74th/stack-chan/schematics/m5-pantilt/m5-pantilt.kicad_pcb

## KiCad design schematics/m5-pantilt/m5-pantilt.kicad_pcb (2024-06-17)

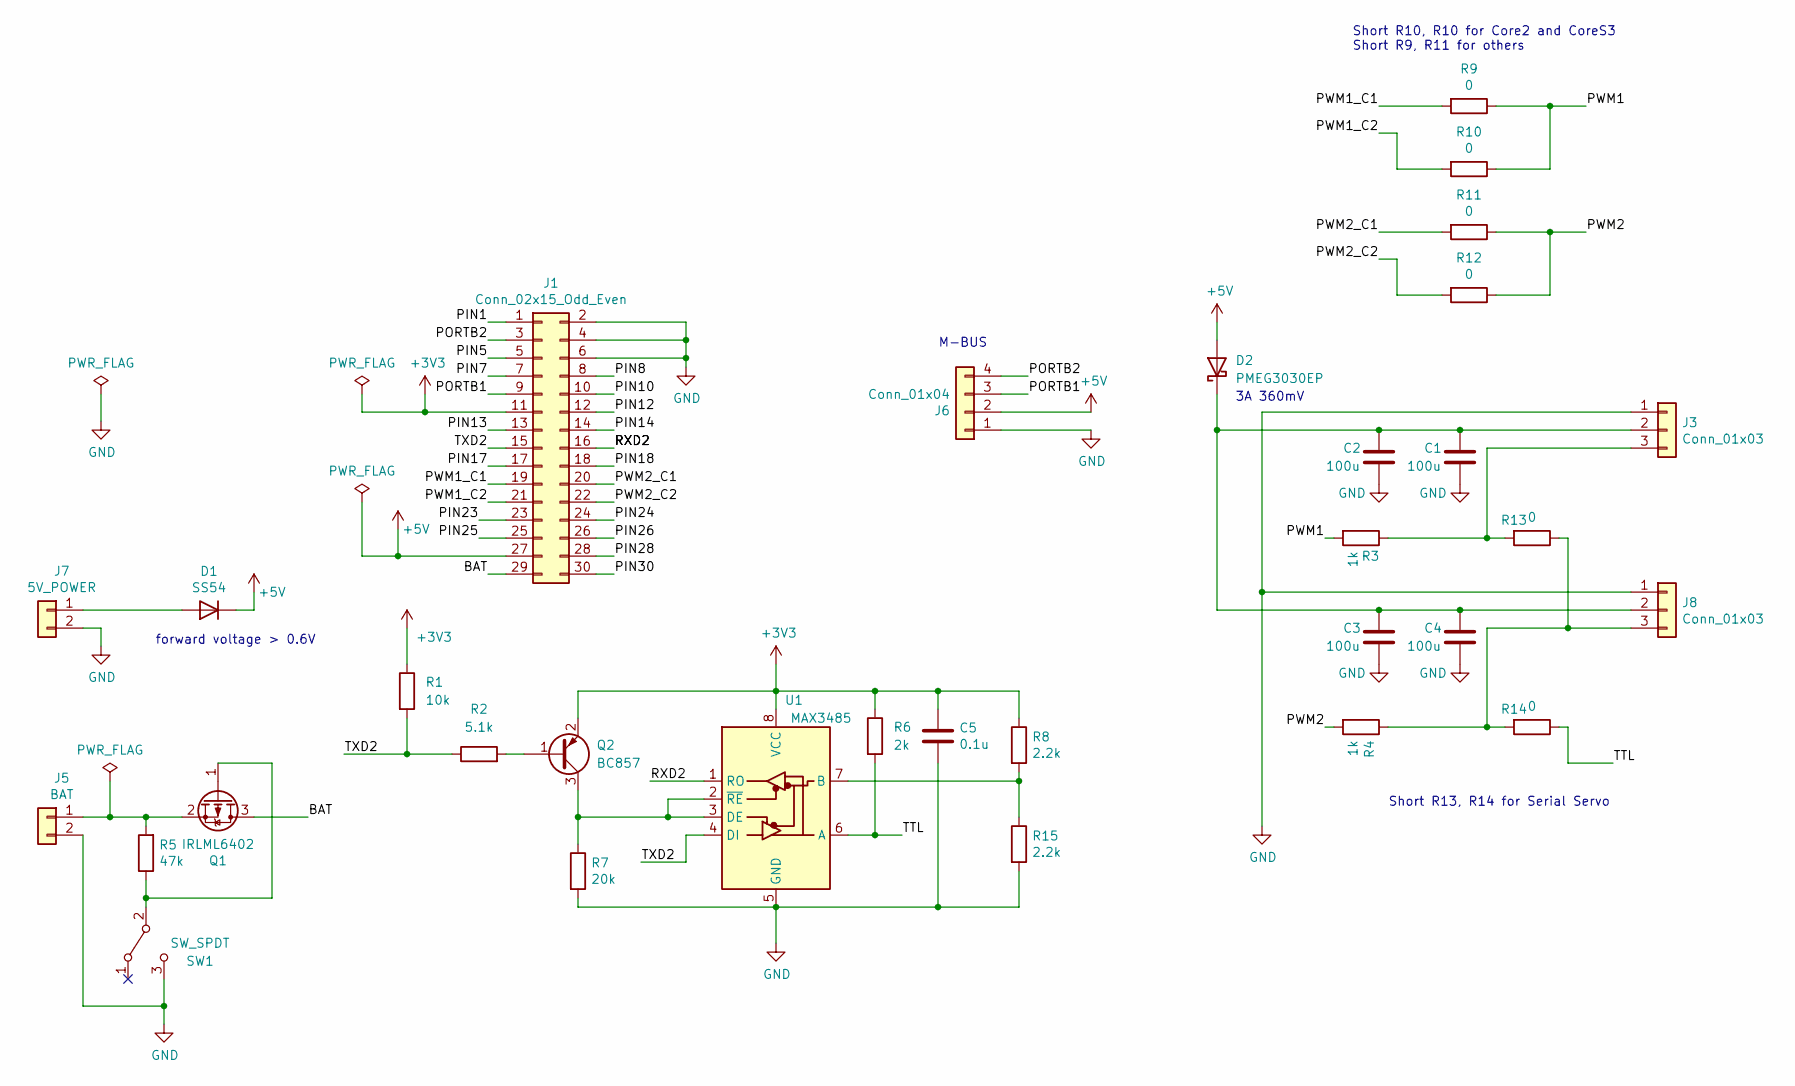
[picture p1: schematic m5-pantilt.kicad_sch]

Parts:
C1, C2, C3, C4: 100u; C_1206_3216Metric_Pad1.33x1.80mm_HandSolder; LCSC C15008
C5: 0.1u; C_0603_1608Metric; LCSC C14663
D1: SS54; D_SMA; LCSC C2931790
D2: PMEG3030EP; D_SOD-128; LCSC C255587
J1: Conn_02x15_Odd_Even; PinHeader_2x15_P2.54mm_Vertical_SMD
J3, J8: Conn_01x03; JST_EH_B3B-EH-A_1x03_P2.50mm_Vertical
J5: BAT; JST_PH_B2B-PH-K_1x02_P2.00mm_Vertical; LCSC C2319
J6: Conn_01x04; JST_PH_S4B-PH-K_1x04_P2.00mm_Horizontal
J7: 5V_POWER; JST_XH_B2B-XH-A_1x02_P2.50mm_Vertical; LCSC C20079
Q1: IRLML6402; SOT-23; LCSC C2886430
Q2: BC857; SOT-23; LCSC C2139
R1: 10k; R_0603_1608Metric; LCSC C25804
R2: 5.1k; R_0603_1608Metric; LCSC C23186
R3, R4: 1k; R_0603_1608Metric_Pad0.98x0.95mm_HandSolder; LCSC C21190
R5: 47k; R_0603_1608Metric_Pad0.98x0.95mm_HandSolder; LCSC C25819
R6: 2k; R_0603_1608Metric; LCSC C22975
R7: 20k; R_0603_1608Metric; LCSC C4184
R8, R15: 2.2k; R_0603_1608Metric; LCSC C4190
R9, R10, R11, R12: 0; R_0603_1608Metric_Pad0.98x0.95mm_HandSolder; LCSC C21189
R13, R14: 0; R_0603_1608Metric; LCSC C21189
SW1: SW_SPDT; SW_CuK_OS102011MA1QN1_SPDT_Angled
U1: MAX3485; SO-8_5.3x6.2mm_P1.27mm; LCSC C668204

Connections:
+3V3: C5.1, J1.11, Q2.2 (E), R1.1, R6.1, R8.1, U1.8 (VCC)
+5V: D1.1 (K), D2.2 (A), J1.27, J6.2
/BAT: J1.29, Q1.3 (D)
/PIN1: J1.1
/PIN5: J1.5
/PIN7: J1.7
/PIN8: J1.8
/PIN10: J1.10
/PIN12: J1.12
/PIN13: J1.13
/PIN14: J1.14
/PIN17: J1.17
/PIN18: J1.18
/PIN23: J1.23
/PIN24: J1.24
/PIN25: J1.25
/PIN26: J1.26
/PIN28: J1.28
/PIN30: J1.30
/PORTB1: J1.9, J6.3
/PORTB2: J1.3, J6.4
/PWM1: R3.2, R9.1, R10.1
/PWM1_C1: J1.19, R9.2
/PWM1_C2: J1.21, R10.2
/PWM2: R4.2, R11.1, R12.1
/PWM2_C1: J1.20, R11.2
/PWM2_C2: J1.22, R12.2
/RXD2: J1.16, U1.1 (RO)
/TTL: R6.2, R14.1, U1.6 (A)
/TXD2: J1.15, R1.2, R2.1, U1.4 (DI)
GND: C1.1, C2.1, C3.2, C4.1, C5.2, J1.2, J1.4, J1.6, J3.1, J5.2, J6.1, J7.2, J8.1, R7.2, R15.2, SW1.3 (C), U1.5 (GND)
unnamed: D1.2 (A), J7.1
unnamed: C1.2, C2.2, C3.1, C4.2, D2.1 (K), J3.2, J8.2
unnamed: J3.3, R3.1, R13.2
unnamed: J5.1, Q1.2 (S), R5.2
unnamed: J8.3, R4.1, R13.1, R14.2
unnamed: Q1.1 (G), R5.1, SW1.2 (B)
unnamed: Q2.1 (B), R2.2
unnamed: Q2.3 (C), R7.1, U1.2 (~RE), U1.3 (DE)
unnamed: R8.2, R15.1, U1.7 (B)

Notes on the sheet:
M-BUS
Short R13, R14 for Serial Servo
forward voltage > 0.6V
3A 360mV
Short R10, R10 for Core2 and CoreS3 Short R9, R11 for others

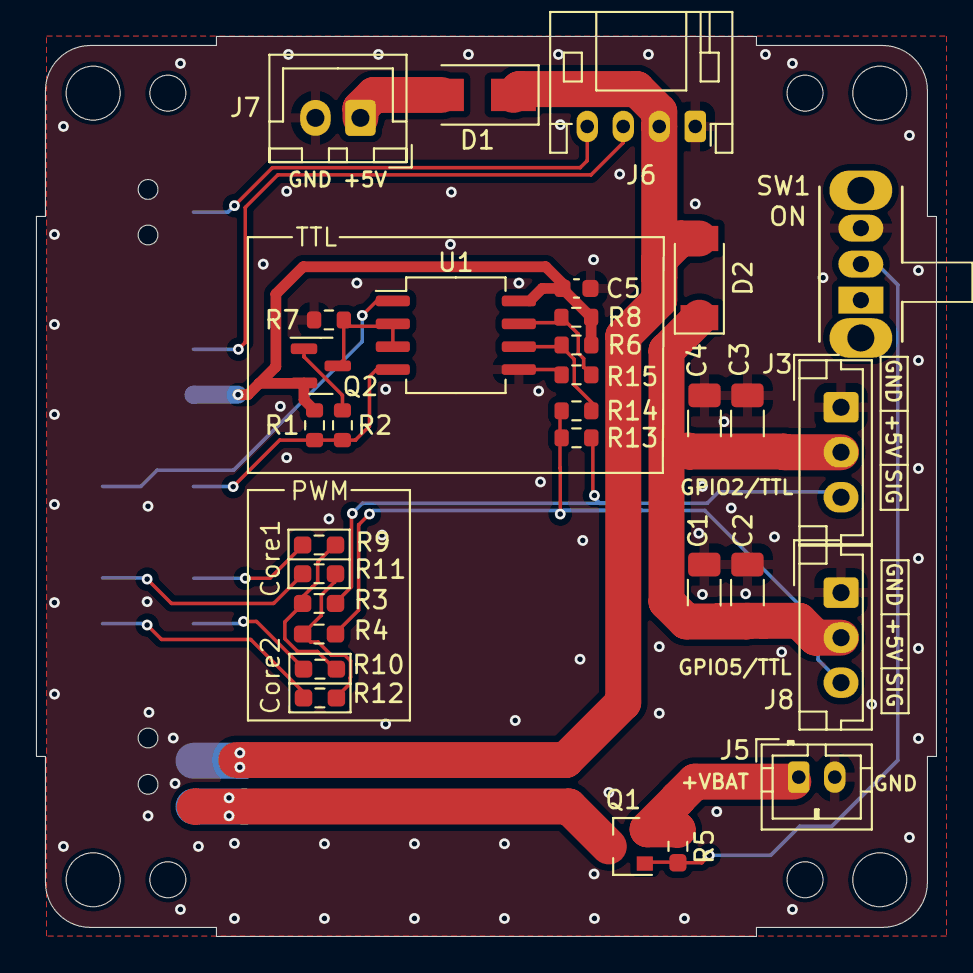
[picture p2: board m5-pantilt.kicad_pcb from above]

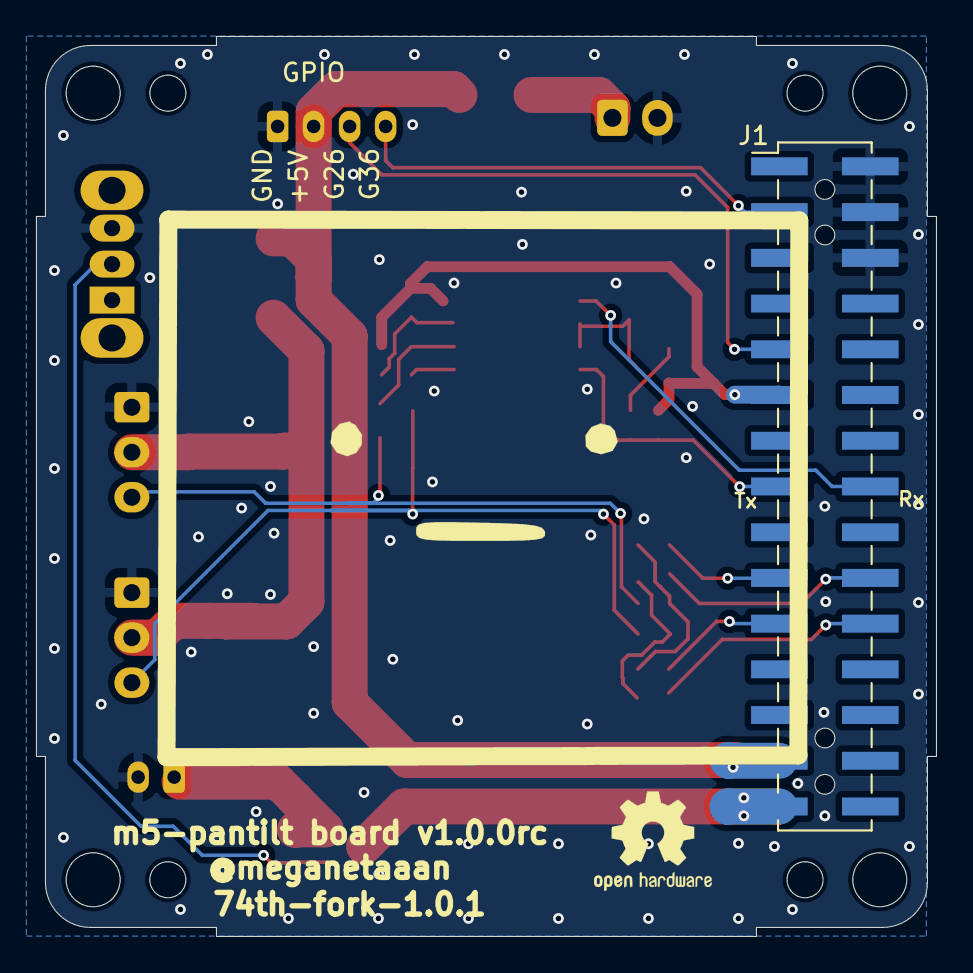
[picture p3: board m5-pantilt.kicad_pcb from below]

Board: 2 copper layers, 50.0 x 50.0 mm, 37 parts (2 on the bottom side), 24 nets.

Other parts of the board:
Hole1, Hole2, Hole3, Hole4: mountinghole_M2_M3
LOGO: LOGO; avatar_small
